ashwathkart/robot-leg/Images/tendon driven leg.jpg

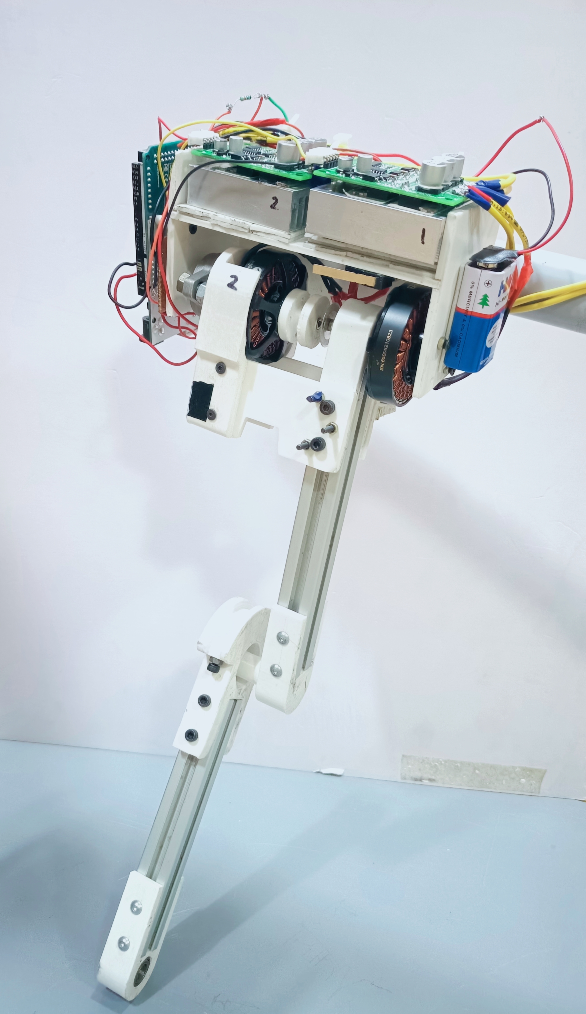
Images/tendon driven leg.jpg
