ashwathkart/robot-leg/README.md

# robot-leg
All the code and STL files used to create the project.

View publication [here](https://ieeexplore.ieee.org/document/10452656).
