ashwathkart/robot-leg/Simulation/aluminum-smol_Default_sldprt.STEP

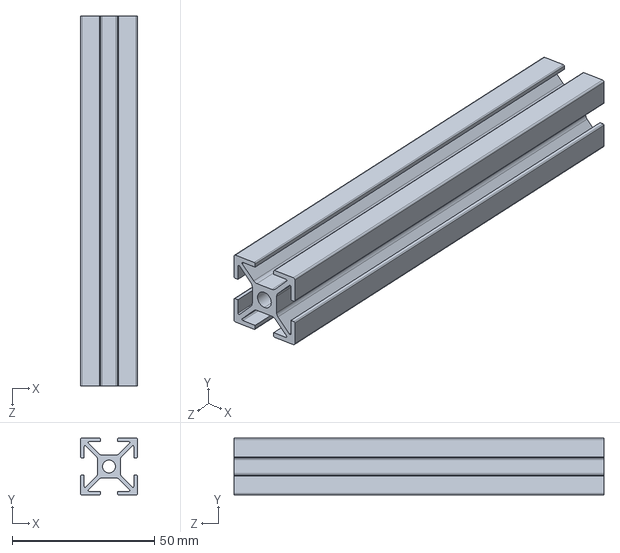
[picture p11: CAD file, 2023-05-26]
Simulation/aluminum-smol_Default_sldprt.STEP
20.0 x 20.0 x 130.0 mm
