ashwathkart/robot-leg/STL Files/cover.STL

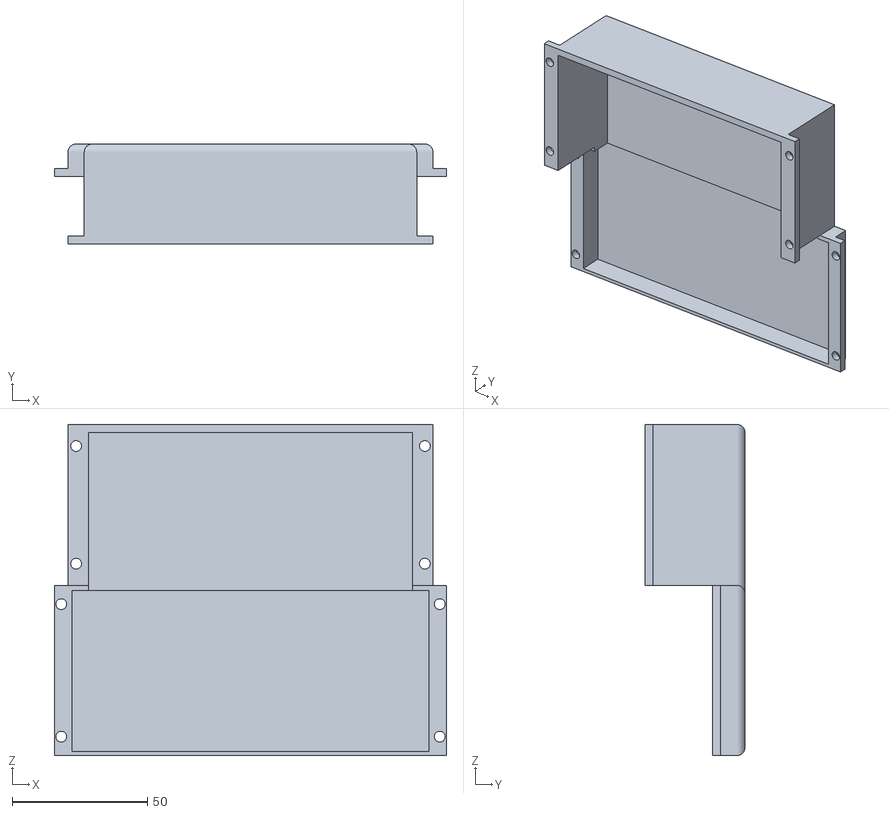
[picture p12: CAD file, 2023-05-26]
STL Files/cover.STL
145.0 x 37.0 x 122.5
