ashwathkart/robot-leg/Simulation/3dprint_knee_joint_Default_sldprt.STEP

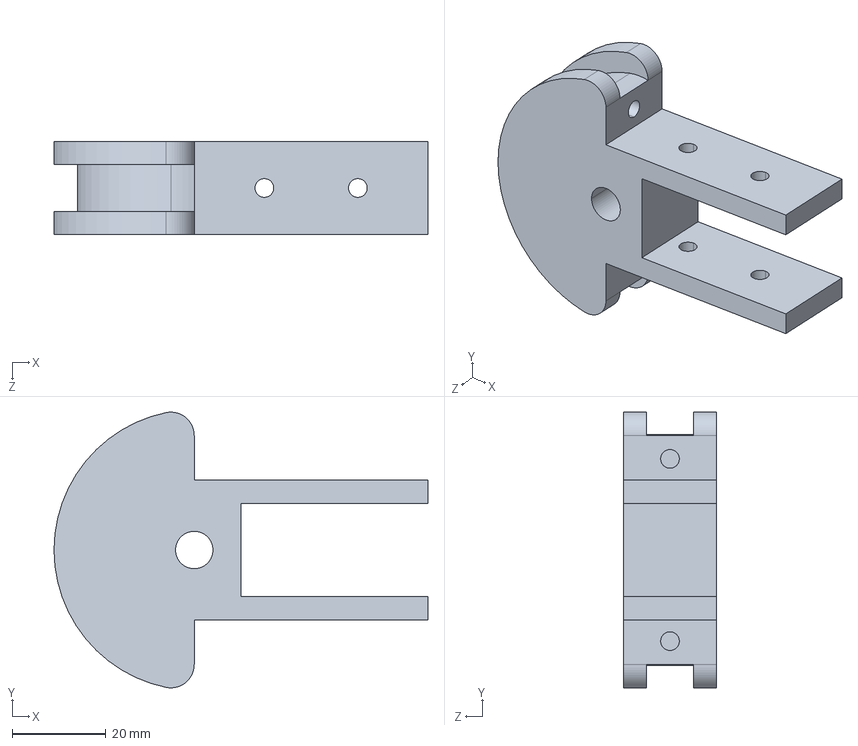
[picture p13: CAD file, 2023-05-26]
Simulation/3dprint_knee_joint_Default_sldprt.STEP
80.0 x 59.0 x 20.0 mm
