ashwathkart/robot-leg/STL Files/3dprint_bearing.STL

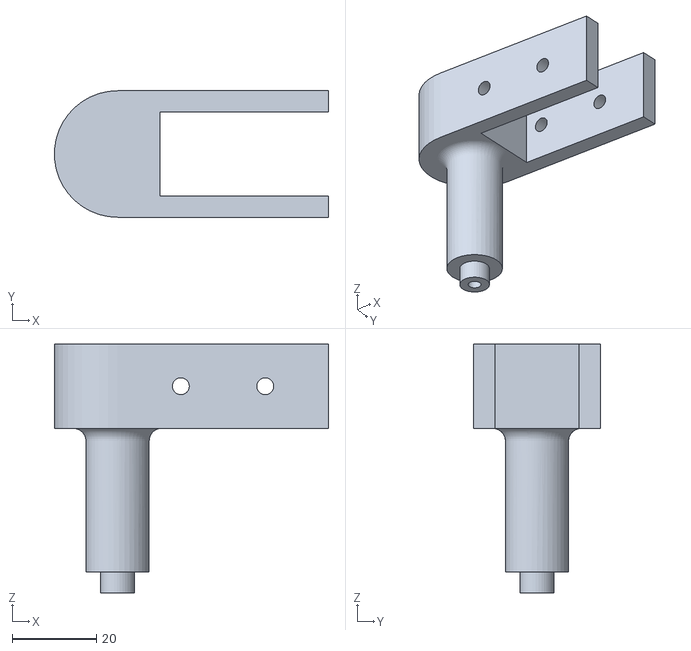
[picture p14: CAD file, 2023-05-26]
STL Files/3dprint_bearing.STL
65.0 x 30.0 x 59.0
