ashwathkart/robot-leg/STL Files/connect_slab_1x.STL

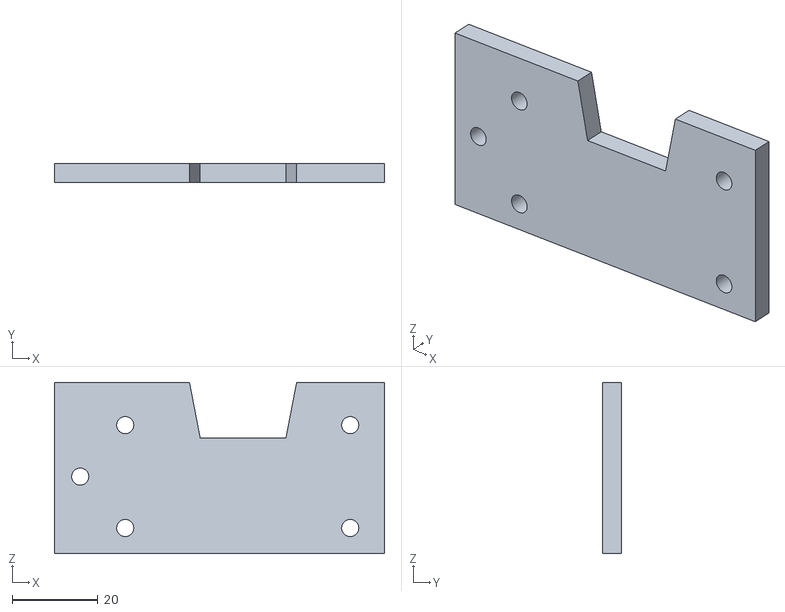
[picture p16: CAD file, 2023-05-26]
STL Files/connect_slab_1x.STL
77.0 x 4.50 x 40.0
