ashwathkart/robot-leg/Simulation/3dprint_bearing_Default_sldprt.STEP

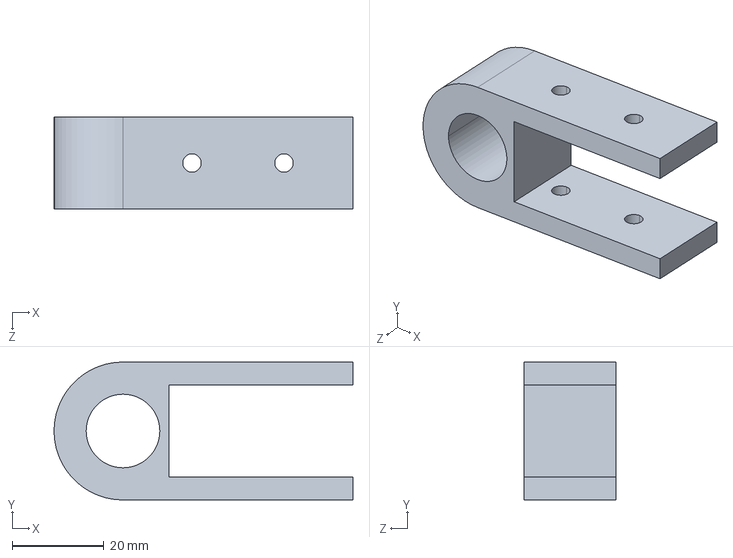
[picture p17: CAD file, 2023-05-26]
Simulation/3dprint_bearing_Default_sldprt.STEP
65.0 x 30.0 x 20.0 mm
