ashwathkart/robot-leg/STL Files/motor_driver_platform.STL

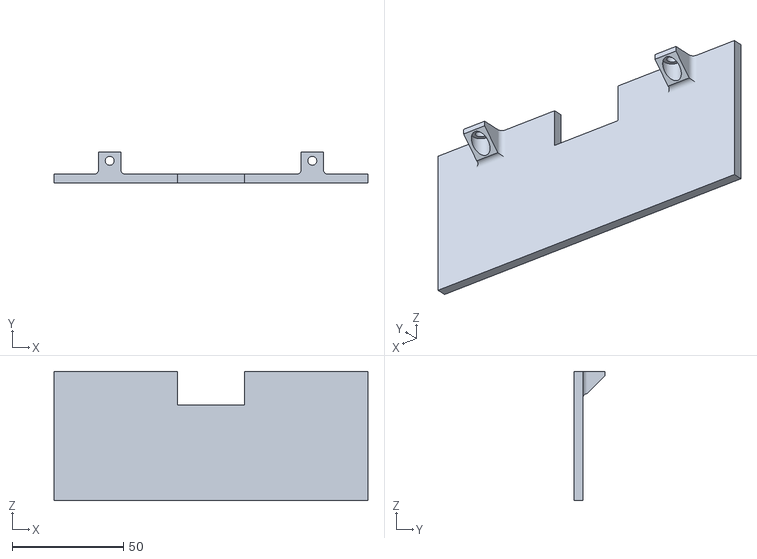
[picture p18: CAD file, 2023-05-26]
STL Files/motor_driver_platform.STL
141.0 x 14.0 x 58.0
