ashwathkart/robot-leg/Simulation/bracket_Default_sldprt.STEP

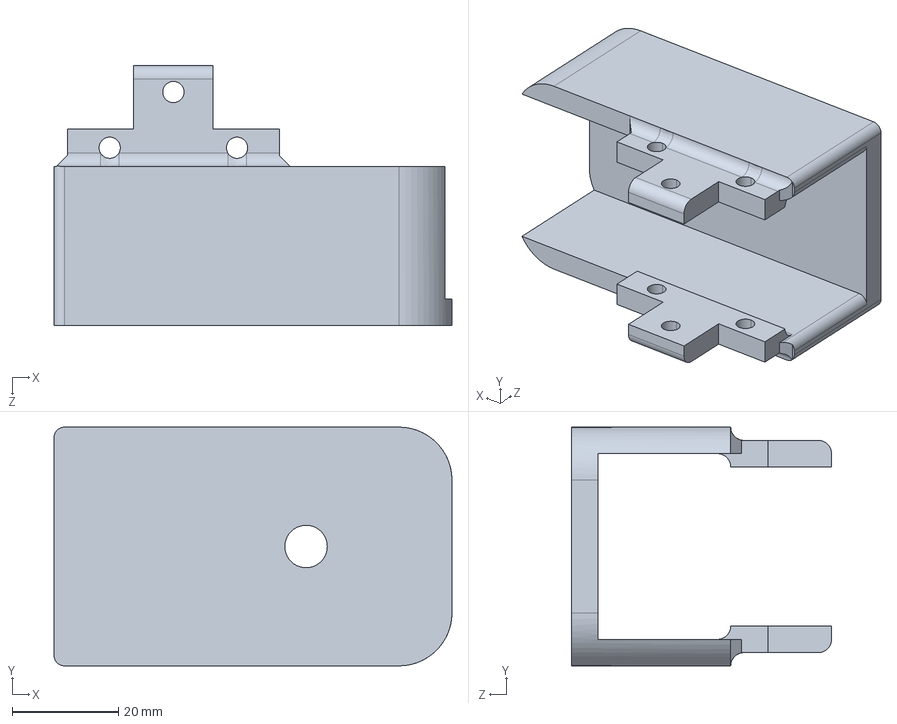
[picture p19: CAD file, 2023-05-26]
Simulation/bracket_Default_sldprt.STEP
75.0 x 45.0 x 49.0 mm
