ashwathkart/robot-leg/STL Files/3dprint_knee_joint.STL

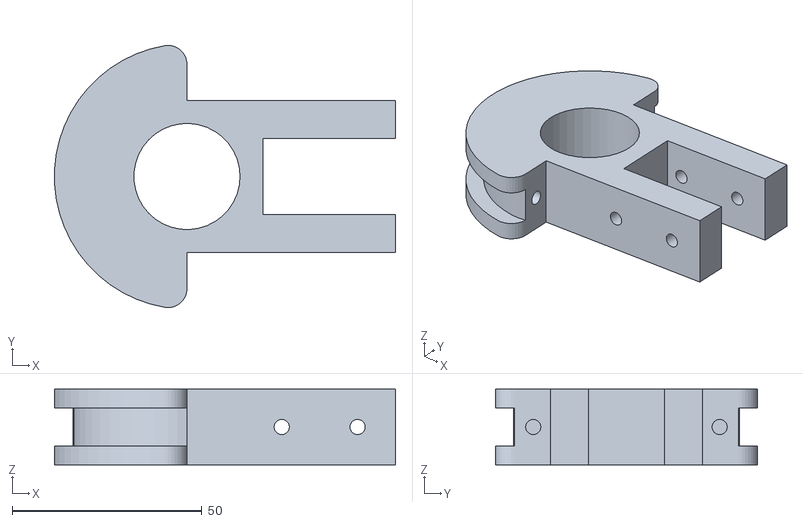
[picture p20: CAD file, 2023-05-26]
STL Files/3dprint_knee_joint.STL
89.9 x 69.2 x 20.0
