ashwathkart/robot-leg/Simulation/aluminum-long_Default_sldprt.STEP

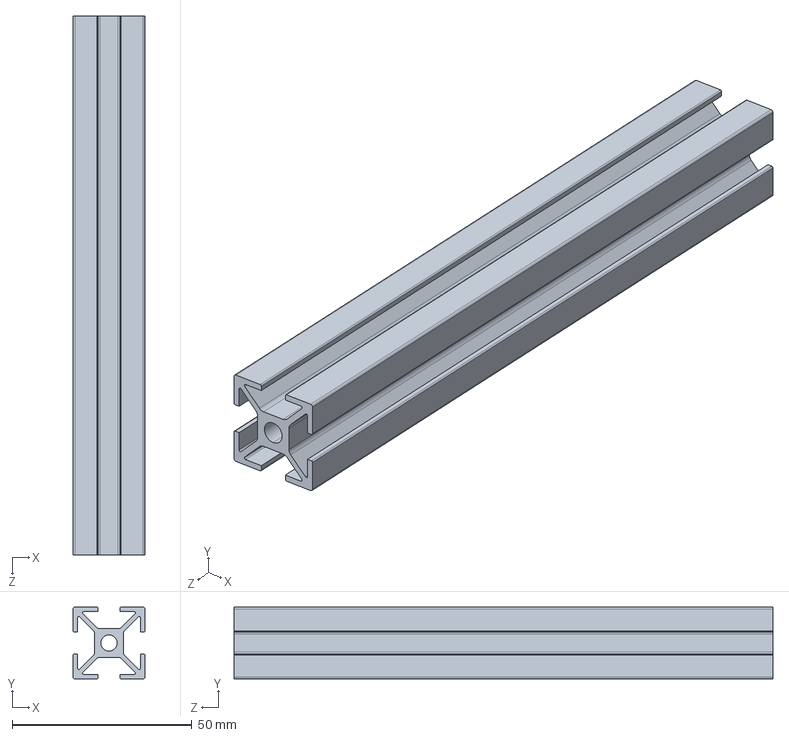
[picture p21: CAD file, 2023-05-26]
Simulation/aluminum-long_Default_sldprt.STEP
20.0 x 20.0 x 150.0 mm
