ashwathkart/robot-leg/STL Files/base_plate.STL

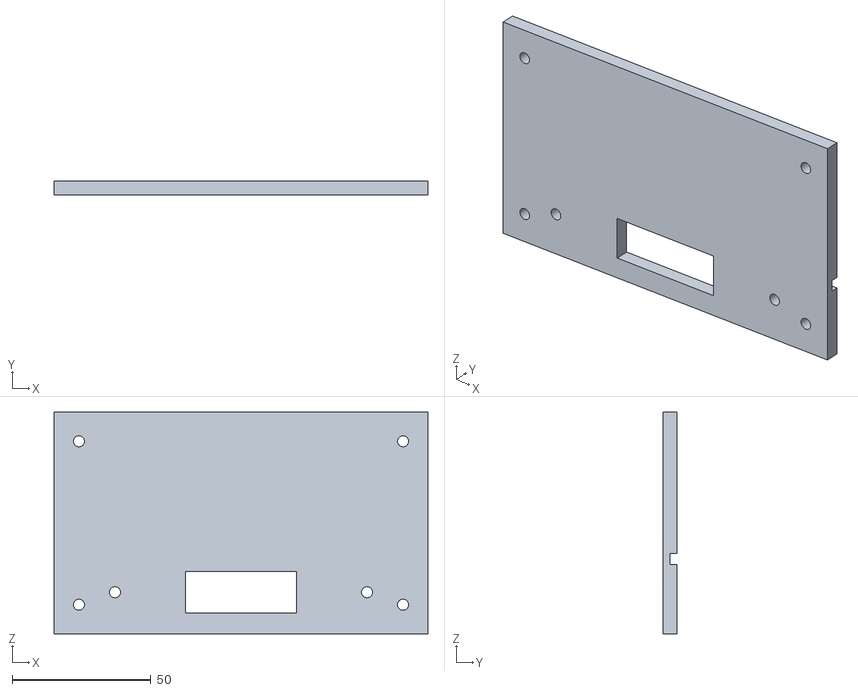
[picture p22: CAD file, 2023-05-26]
STL Files/base_plate.STL
135.0 x 5.00 x 80.0
