ashwathkart/robot-leg/Simulation/connect_Default_sldprt.STEP

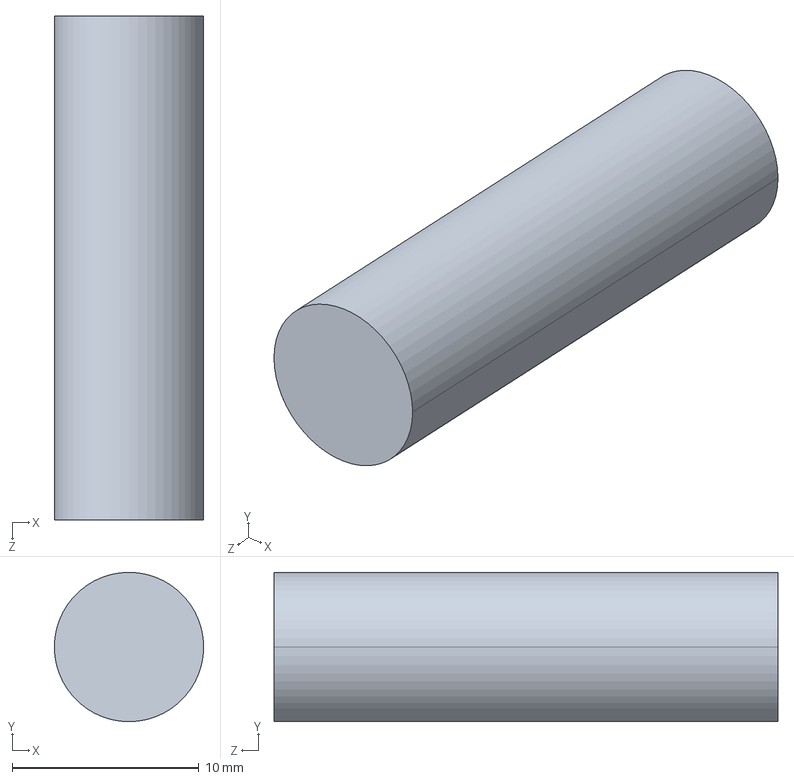
[picture p23: CAD file, 2023-05-26]
Simulation/connect_Default_sldprt.STEP
8.00 x 8.00 x 27.0 mm
