ashwathkart/robot-leg/STL Files/left_plate.STL

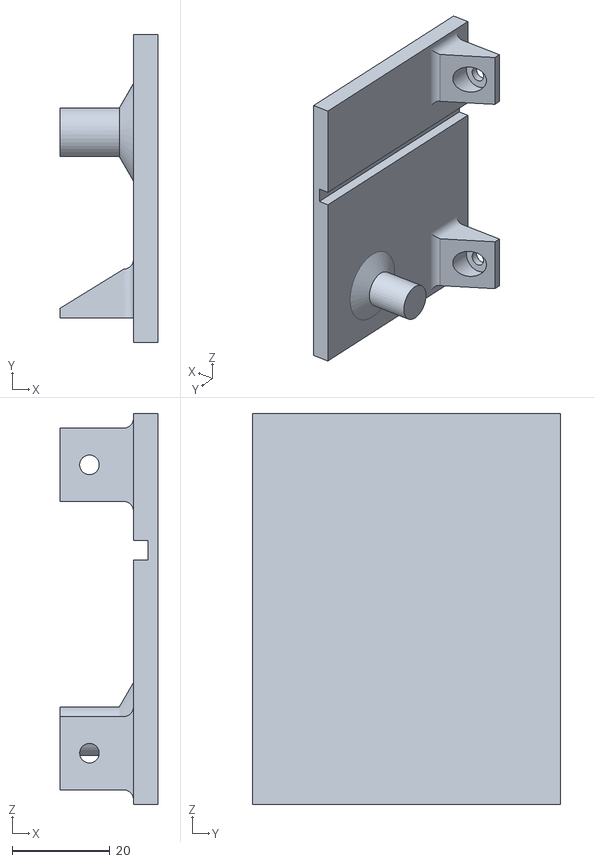
[picture p24: CAD file, 2023-05-26]
STL Files/left_plate.STL
20.0 x 63.0 x 80.0
