ashwathkart/robot-leg/Simulation/feet_Default_sldprt.STEP

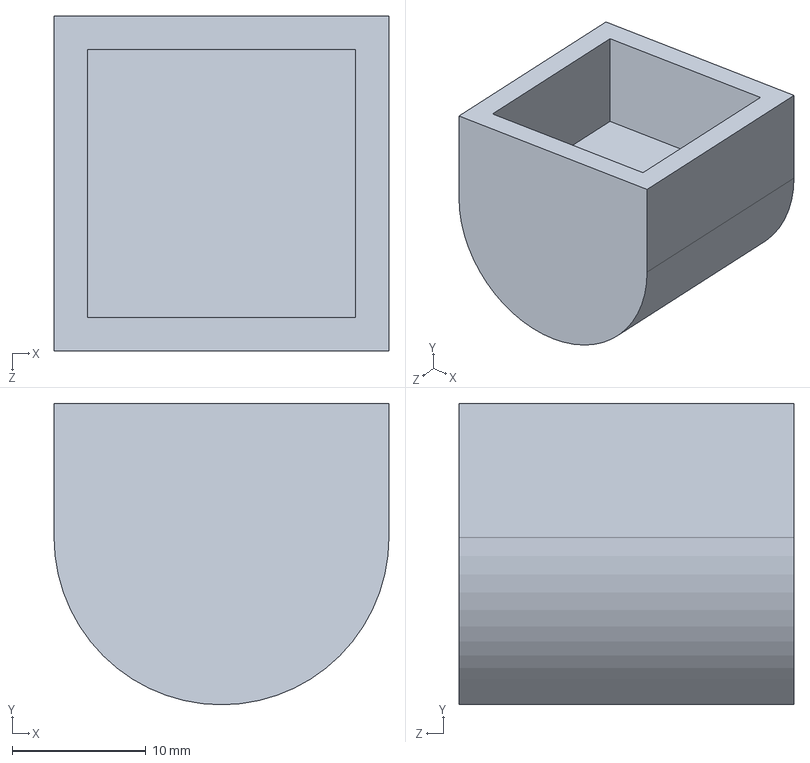
[picture p25: CAD file, 2023-05-26]
Simulation/feet_Default_sldprt.STEP
25.0 x 22.5 x 25.0 mm
