ashwathkart/robot-leg/STL Files/3dprint_hip_joint.STL

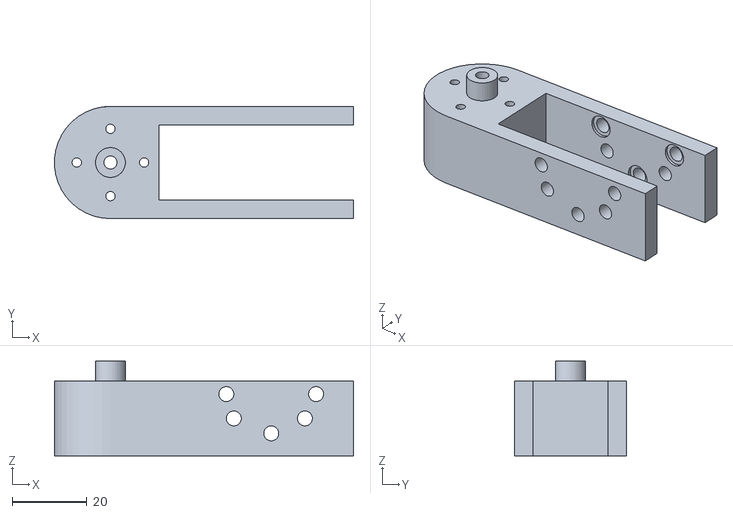
[picture p26: CAD file, 2023-05-26]
STL Files/3dprint_hip_joint.STL
80.0 x 30.0 x 25.3
