ashwathkart/robot-leg/STL Files/encoder_plate.STL

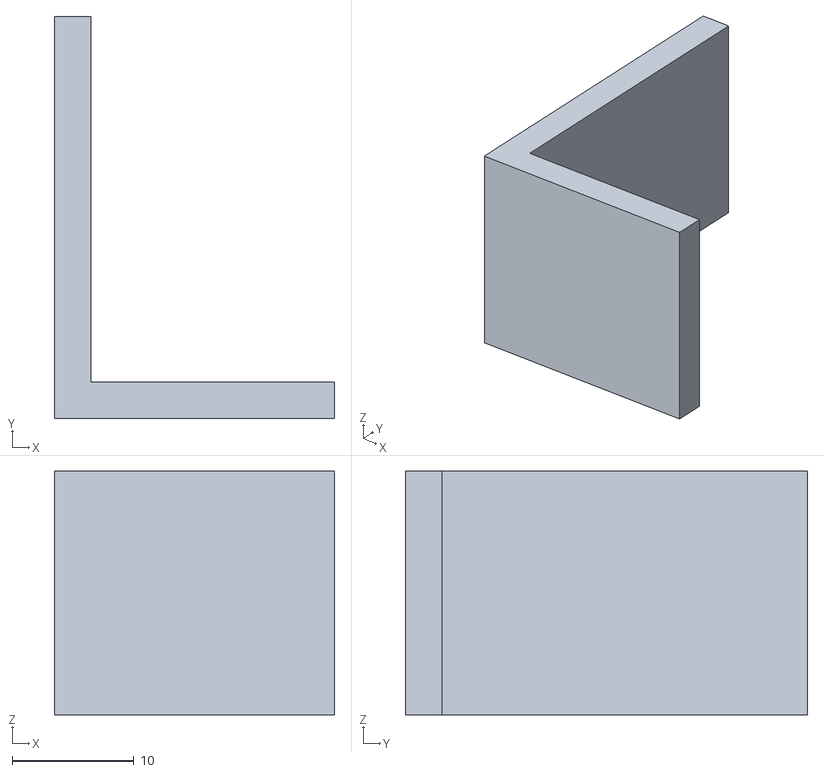
[picture p27: CAD file, 2023-05-26]
STL Files/encoder_plate.STL
23.0 x 33.0 x 20.0
