ashwathkart/robot-leg/STL Files/right_plate.STL

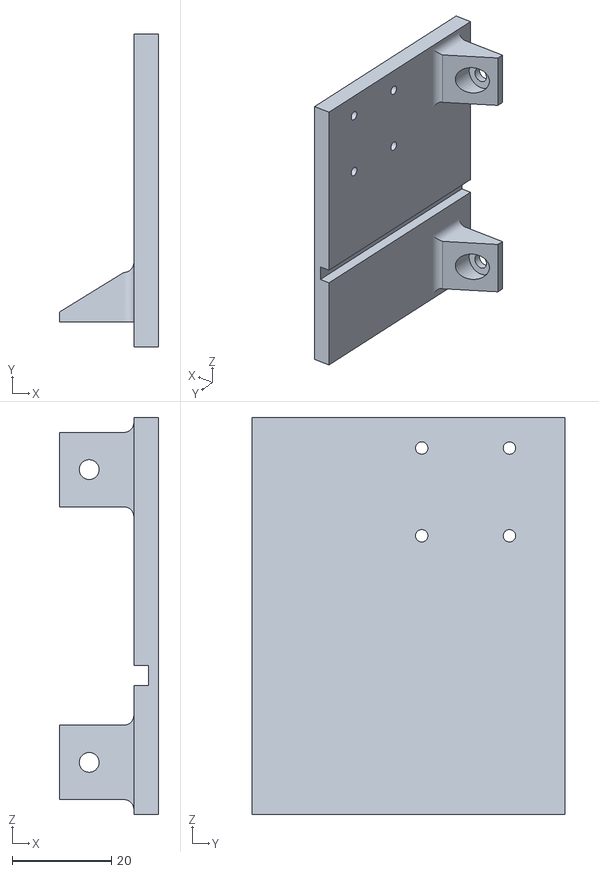
[picture p28: CAD file, 2023-05-26]
STL Files/right_plate.STL
20.0 x 63.0 x 80.0
