ashwathkart/robot-leg/STL Files/arduino_base.STL

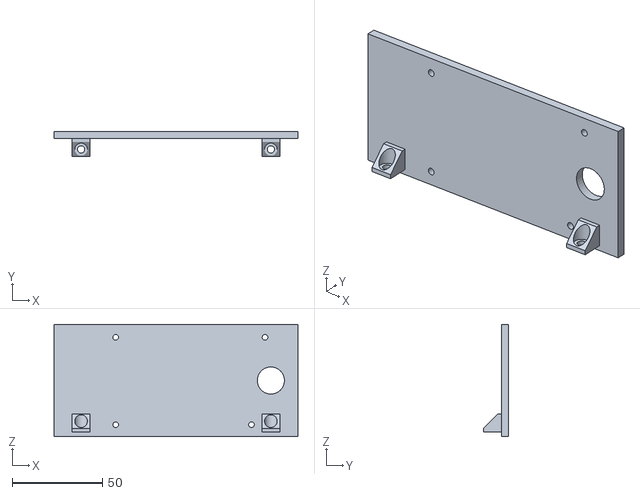
[picture p29: CAD file, 2023-05-26]
STL Files/arduino_base.STL
135.0 x 14.0 x 62.0
